guilhermefernandesk/sensor-capacitivo/README.md

# Projeto Sensor Capacitivo de nível
Construção de um sensor capacitivo de nível, utilizando um circuito integrado 555 na configuração monoestável. A fim de mensurar a variação de capacitância e equacionar o nível de líquido presente.

## Imagens:
  
  
